AliDarSilenzio/alidu-otamatone/docs/img/tasti.jpg

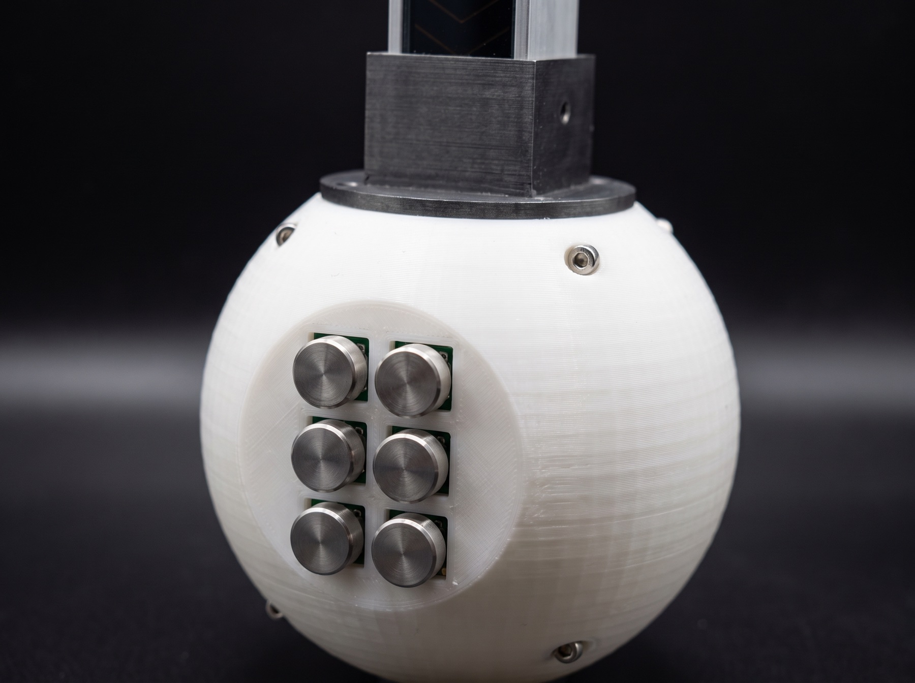
docs/img/tasti.jpg
