AliDarSilenzio/alidu-otamatone/docs/img/nastro.jpg

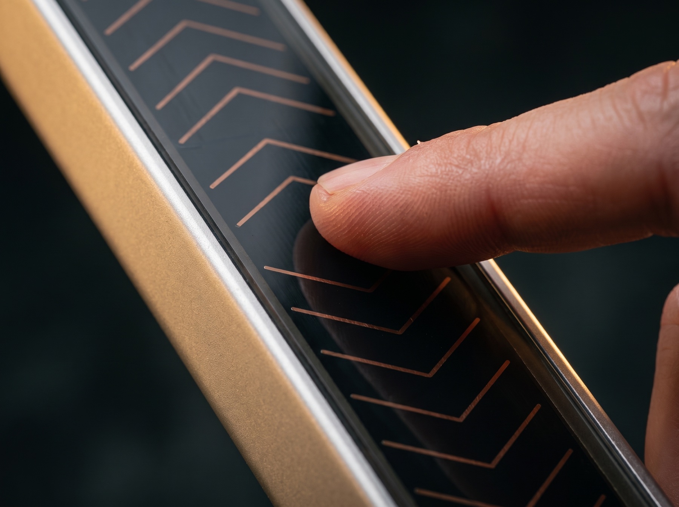
docs/img/nastro.jpg
