AliDarSilenzio/alidu-otamatone/docs/img/connettori.jpg

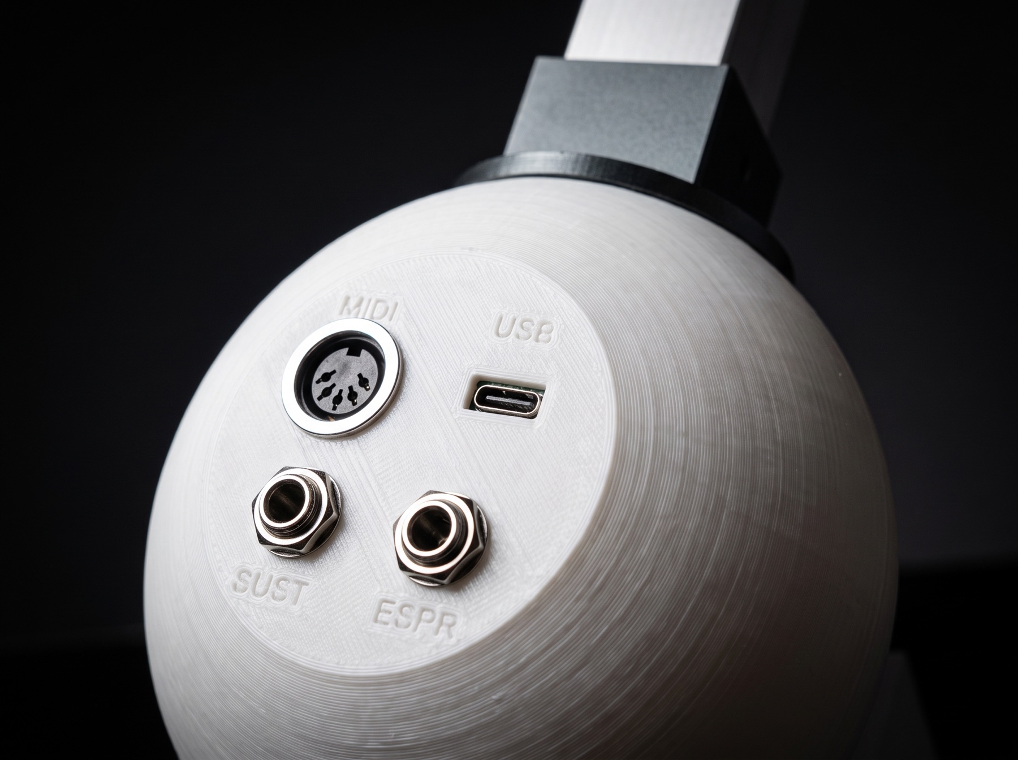
docs/img/connettori.jpg
