AliDarSilenzio/alidu-otamatone/docs/img/esploso.jpg

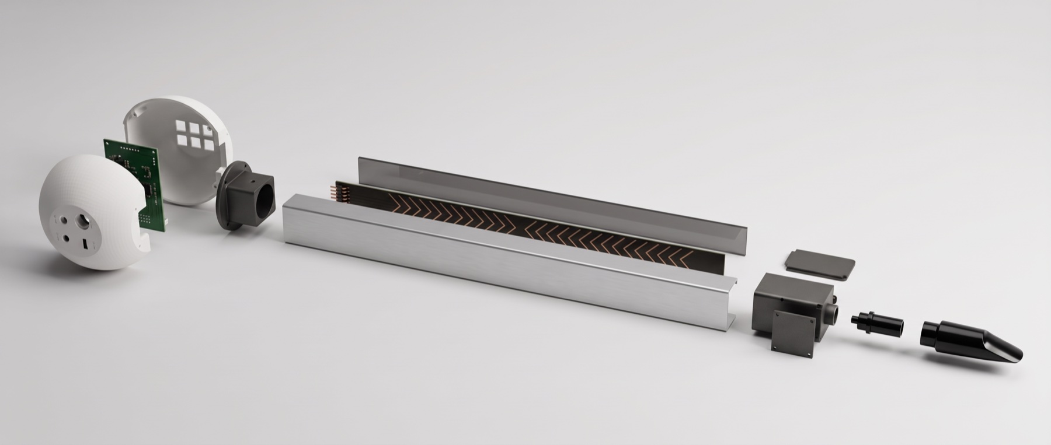
docs/img/esploso.jpg
