AliDarSilenzio/alidu-otamatone/docs/img/mec_assieme.png

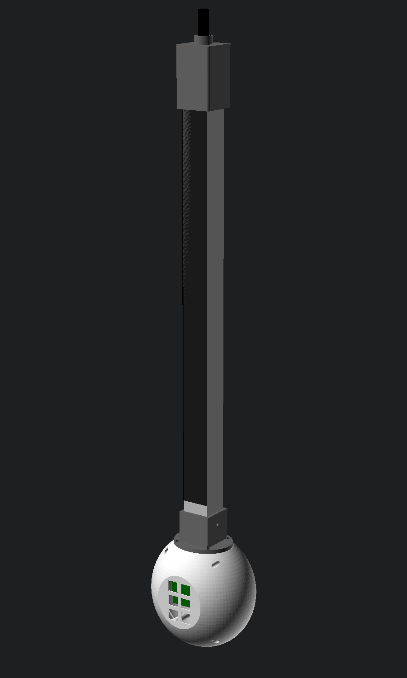
docs/img/mec_assieme.png
