AliDarSilenzio/alidu-otamatone/docs/img/mec_corpo_fronte.png

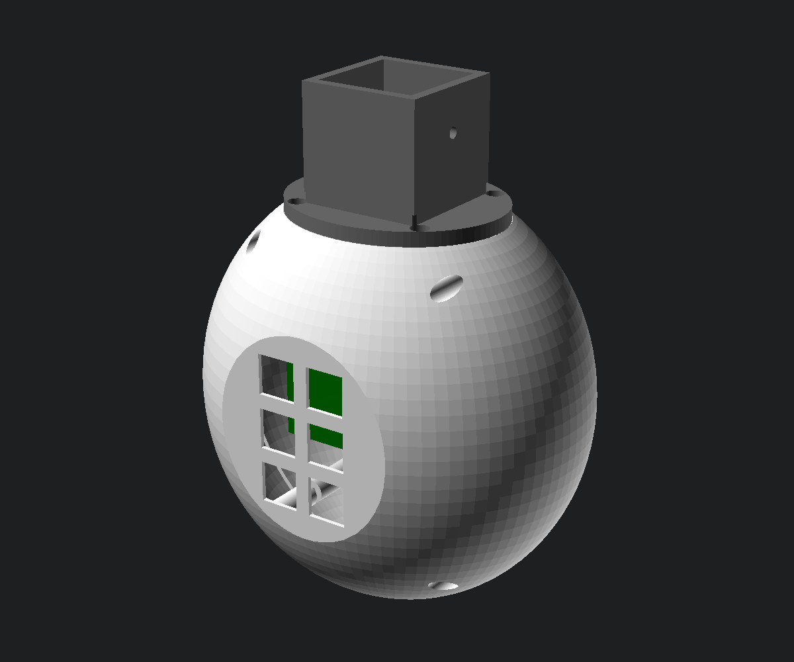
docs/img/mec_corpo_fronte.png
