AliDarSilenzio/alidu-otamatone/docs/img/mec_pezzi.png

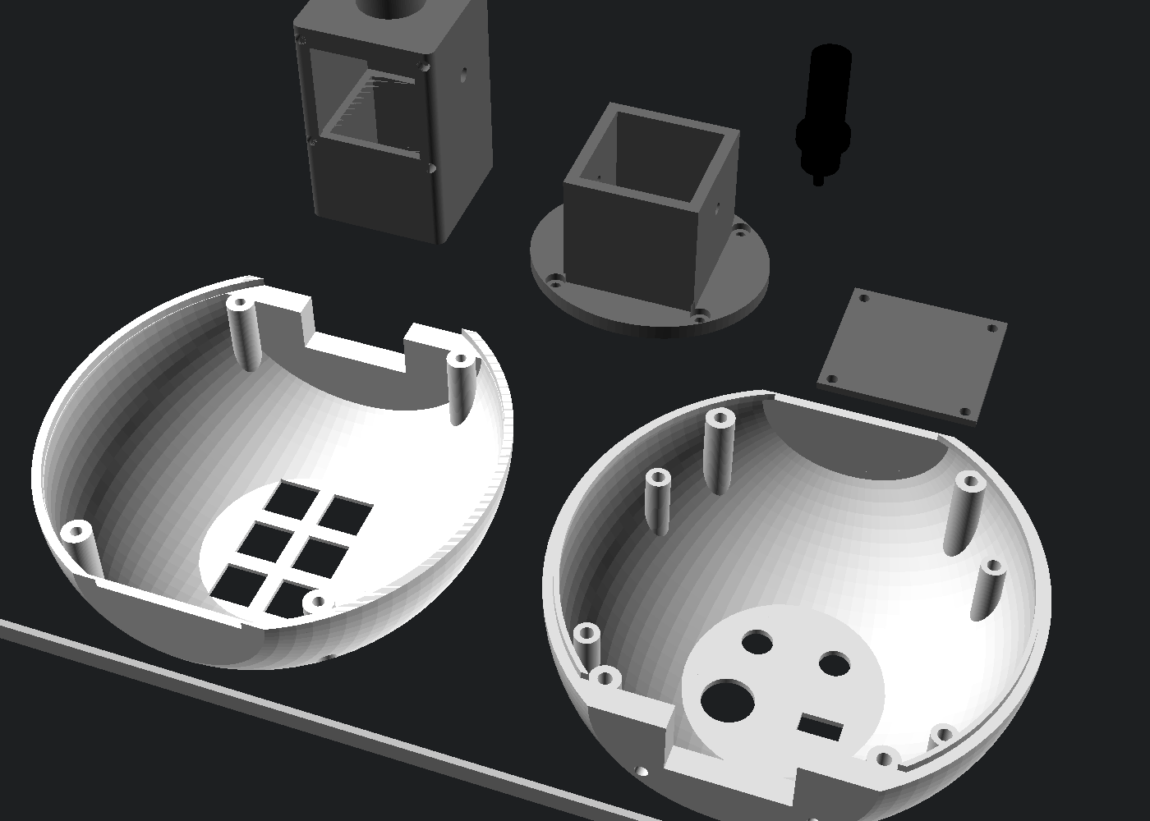
docs/img/mec_pezzi.png
