AliDarSilenzio/alidu-otamatone/docs/img/mec_spaccato.png

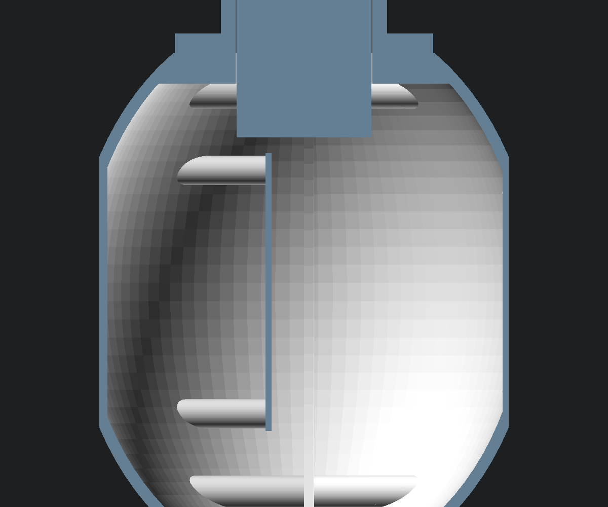
docs/img/mec_spaccato.png
