AliDarSilenzio/alidu-otamatone/docs/img/musicista.jpg

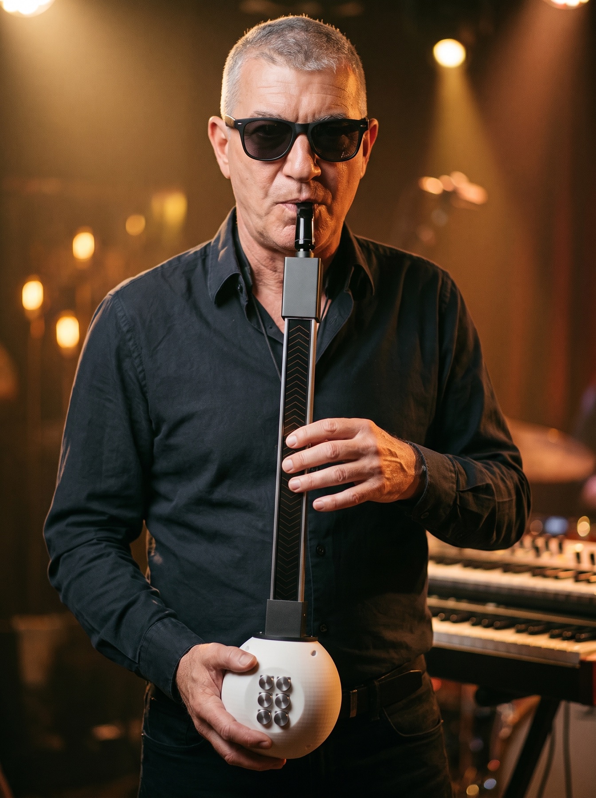
docs/img/musicista.jpg
