AliDarSilenzio/alidu-otamatone/docs/img/pcb_nastro_3d.png

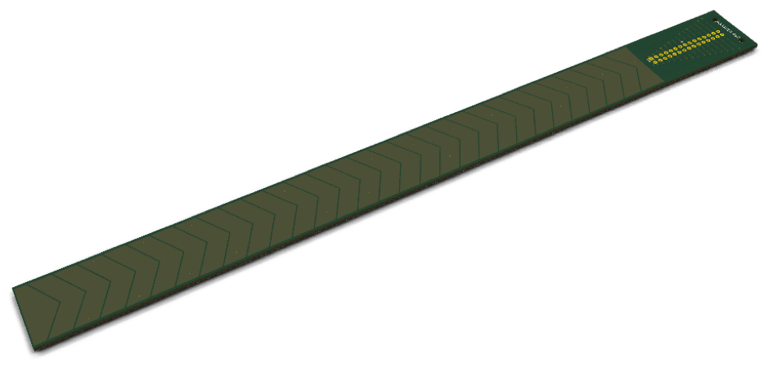
docs/img/pcb_nastro_3d.png
