AliDarSilenzio/alidu-otamatone/docs/img/pcb_nastro_fronte.png

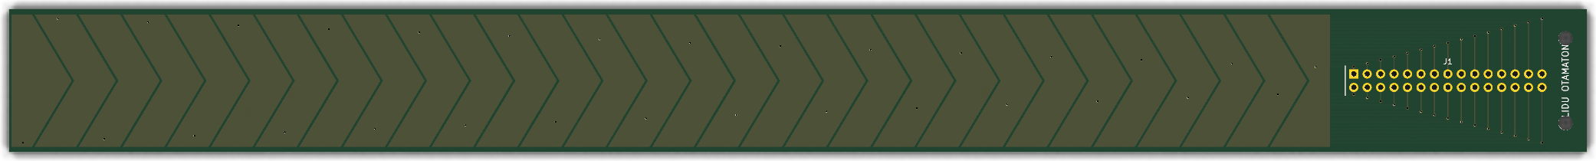
docs/img/pcb_nastro_fronte.png
