AliDarSilenzio/alidu-otamatone/docs/img/pcb_nastro_retro.png

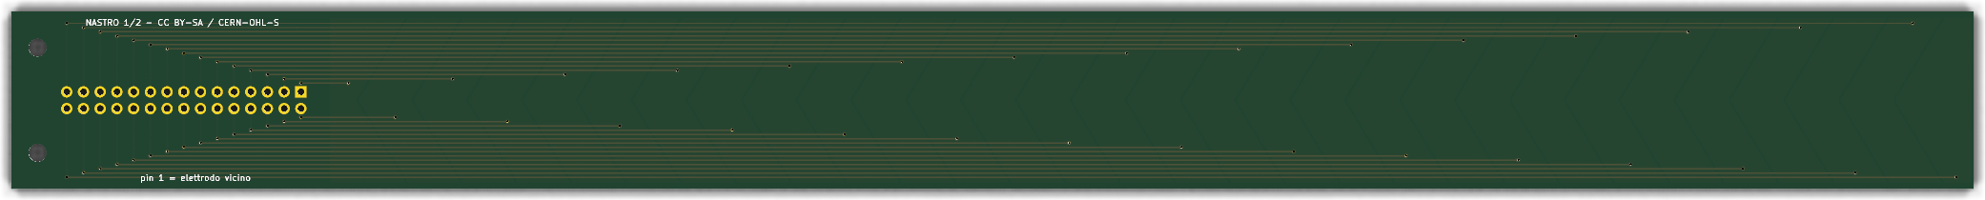
docs/img/pcb_nastro_retro.png
