AliDarSilenzio/alidu-otamatone/docs/img/pcb_scheda_3d.png

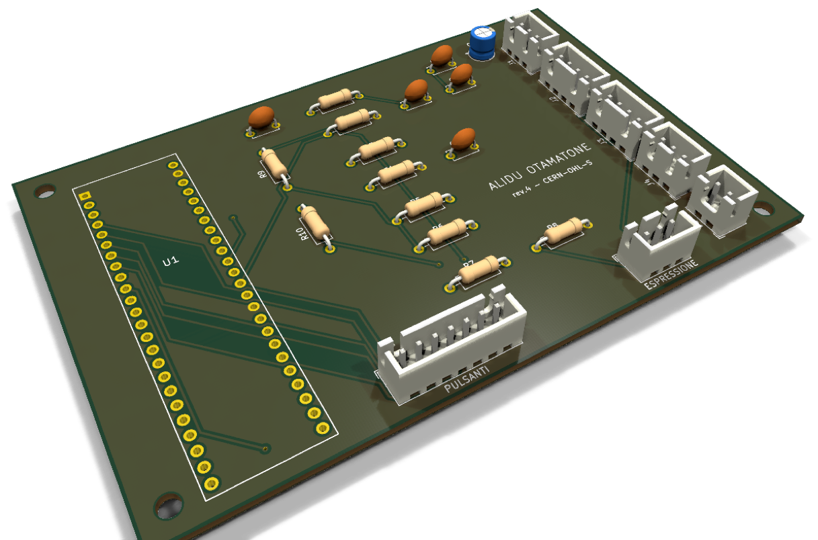
docs/img/pcb_scheda_3d.png
