AliDarSilenzio/alidu-otamatone/docs/img/pcb_scheda_fronte.png

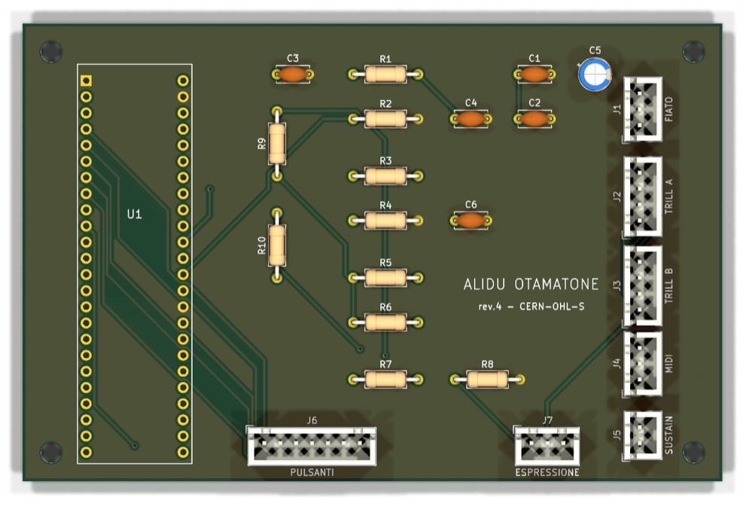
docs/img/pcb_scheda_fronte.png
