AliDarSilenzio/alidu-otamatone/docs/img/pcb_scheda_retro.png

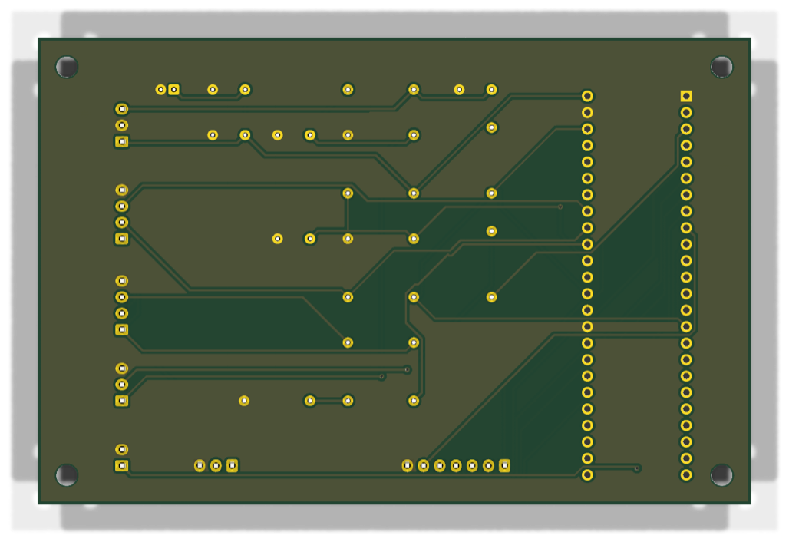
docs/img/pcb_scheda_retro.png
