AliDarSilenzio/alidu-otamatone/docs/img/prodotto.jpg

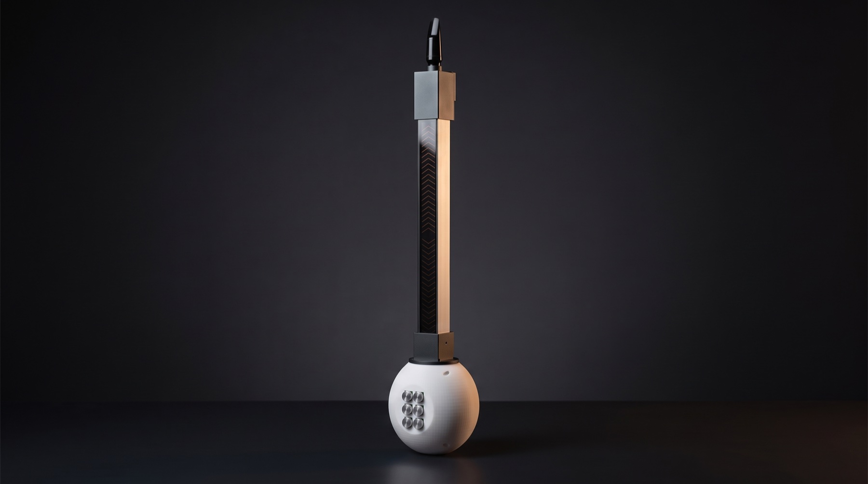
docs/img/prodotto.jpg
