AliDarSilenzio/alidu-otamatone/hardware/nastro/nastro_3d.png

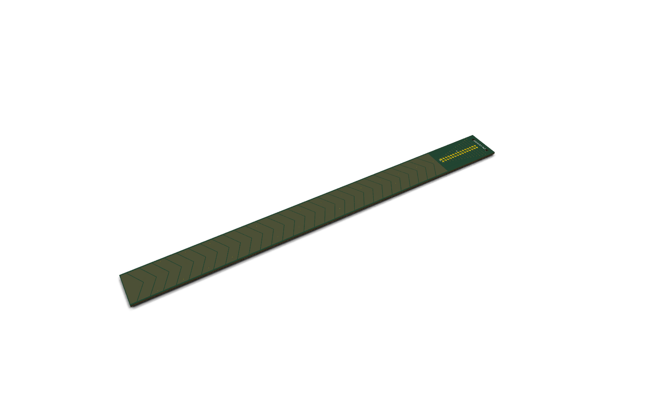
hardware/nastro/nastro_3d.png
