AliDarSilenzio/alidu-otamatone/hardware/nastro/nastro_fronte.png

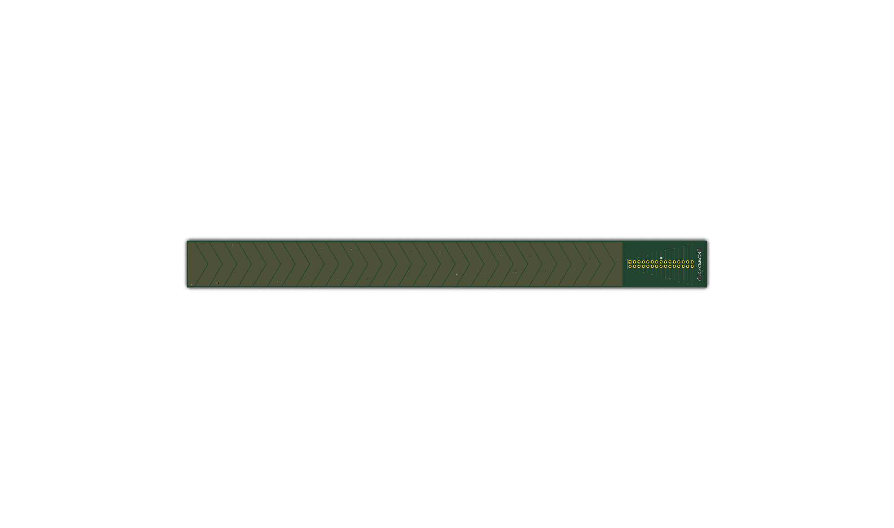
hardware/nastro/nastro_fronte.png
