AliDarSilenzio/alidu-otamatone/hardware/scheda/scheda_3d.png

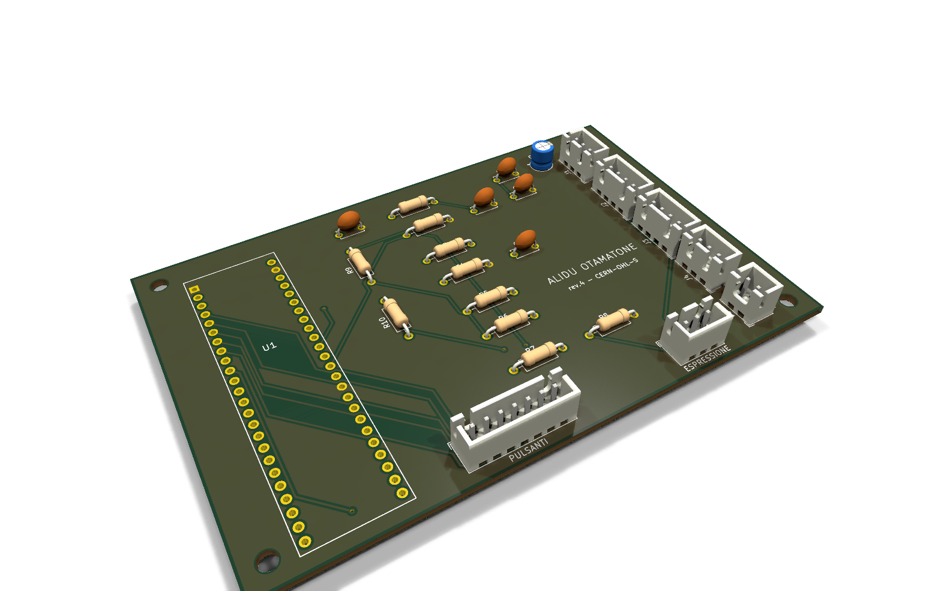
hardware/scheda/scheda_3d.png
