AliDarSilenzio/alidu-otamatone/hardware/scheda/scheda_fronte.png

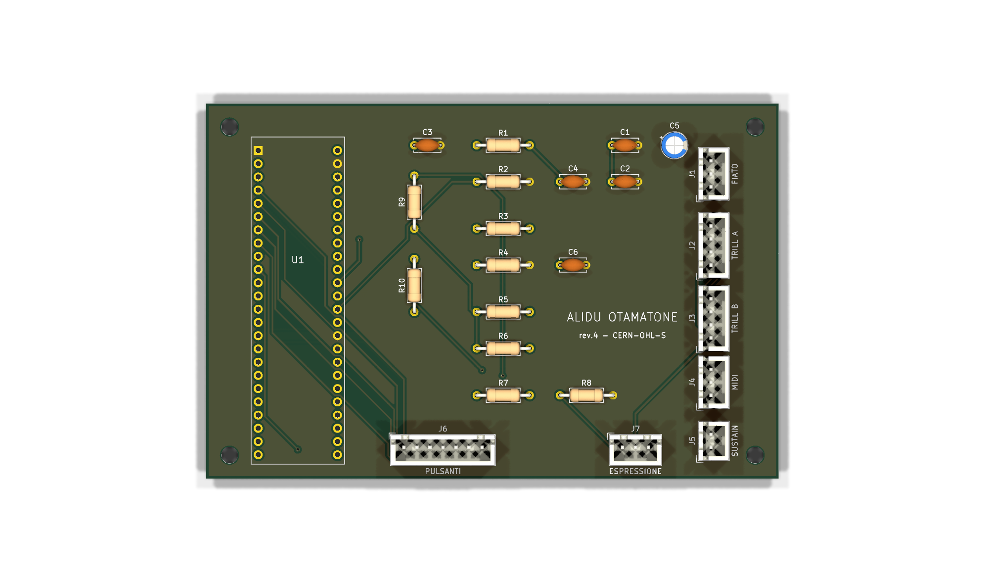
hardware/scheda/scheda_fronte.png
