AliDarSilenzio/alidu-otamatone/hardware/scheda/scheda_retro.png

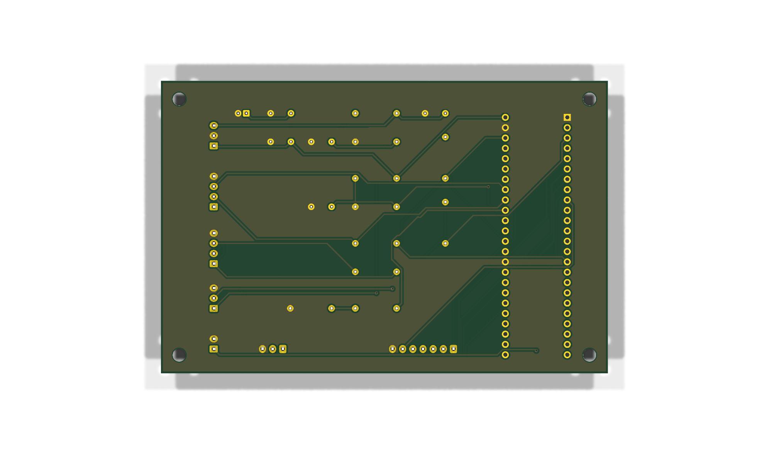
hardware/scheda/scheda_retro.png
