AliDarSilenzio/alidu-otamatone/hardware/meccanica/stl/collare.stl

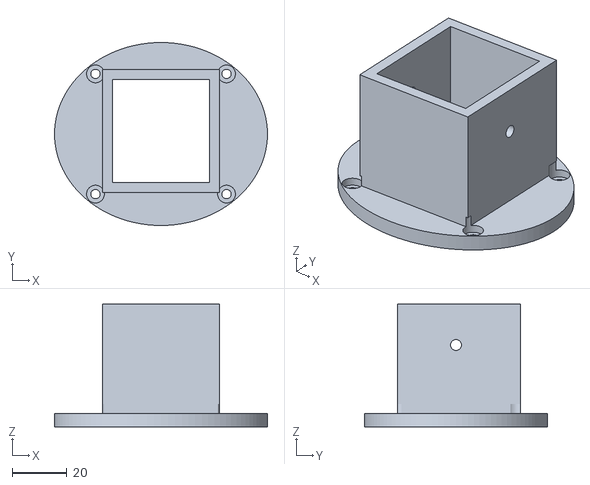
[picture p22: CAD file, 2026-10-10]
hardware/meccanica/stl/collare.stl
78.0 x 67.0 x 45.0
