AliDarSilenzio/alidu-otamatone/hardware/meccanica/stl/testa.stl

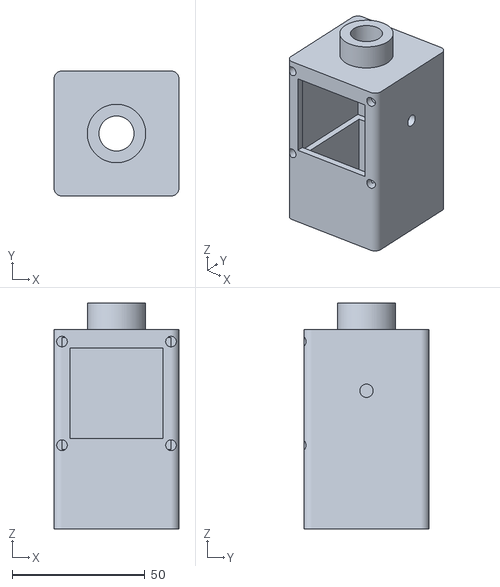
[picture p23: CAD file, 2026-10-10]
hardware/meccanica/stl/testa.stl
47.0 x 47.0 x 85.0
