AliDarSilenzio/alidu-otamatone/hardware/meccanica/stl/corpo_anteriore.stl

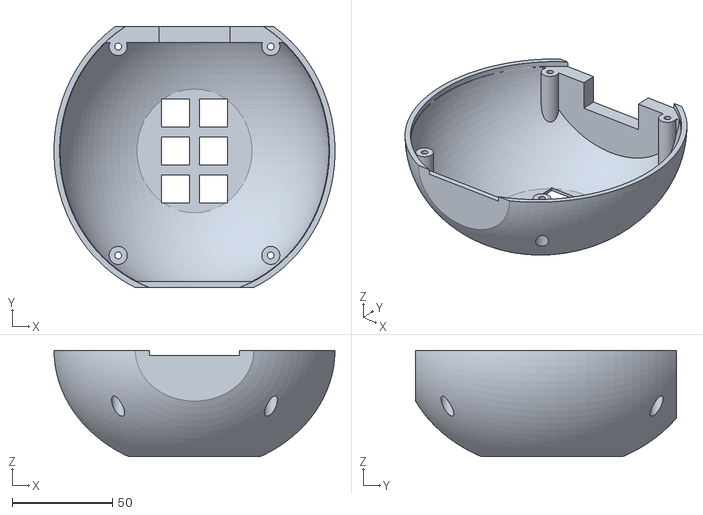
[picture p24: CAD file, 2026-10-10]
hardware/meccanica/stl/corpo_anteriore.stl
139.9 x 130.0 x 53.0
