AliDarSilenzio/alidu-otamatone/hardware/meccanica/stl/guida_nastro.stl

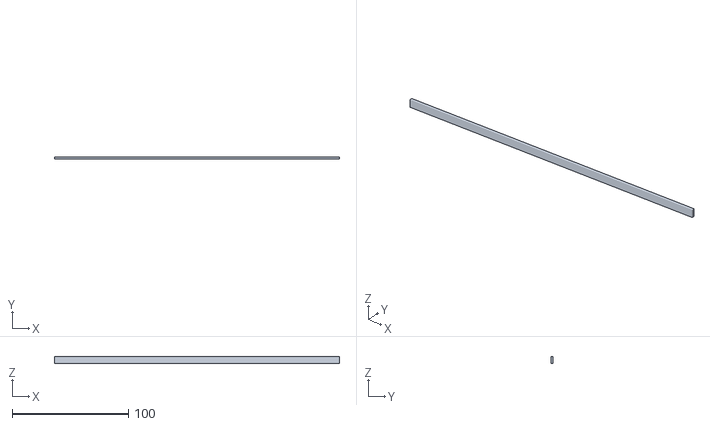
[picture p25: CAD file, 2026-10-10]
hardware/meccanica/stl/guida_nastro.stl
245.0 x 2.00 x 6.00
