AliDarSilenzio/alidu-otamatone/hardware/meccanica/stl/innesto_bocchino.stl

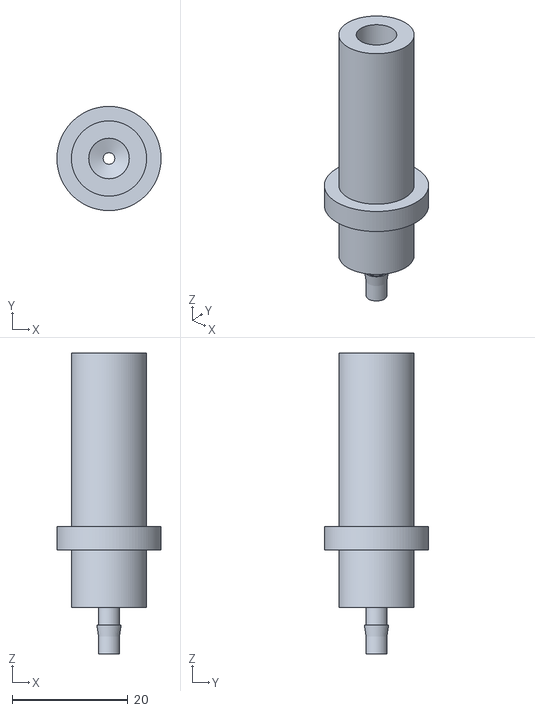
[picture p26: CAD file, 2026-10-10]
hardware/meccanica/stl/innesto_bocchino.stl
18.0 x 18.0 x 52.0
