AliDarSilenzio/alidu-otamatone/hardware/meccanica/stl/testa_coperchio.stl

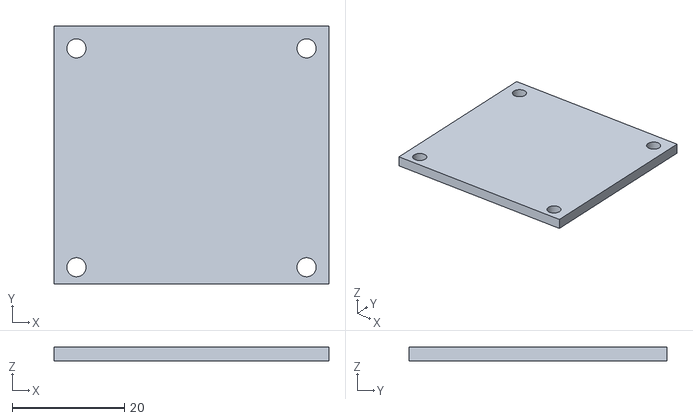
[picture p27: CAD file, 2026-10-10]
hardware/meccanica/stl/testa_coperchio.stl
49.0 x 46.0 x 2.50
