AliDarSilenzio/alidu-otamatone/hardware/meccanica/stl/corpo_posteriore.stl

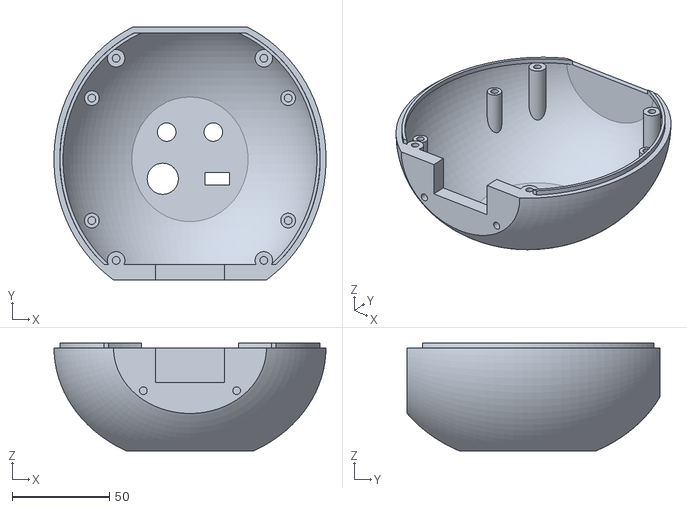
[picture p28: CAD file, 2026-10-10]
hardware/meccanica/stl/corpo_posteriore.stl
139.9 x 130.0 x 55.5
