AliDarSilenzio/alidu-otamatone/docs/img/testa.jpg

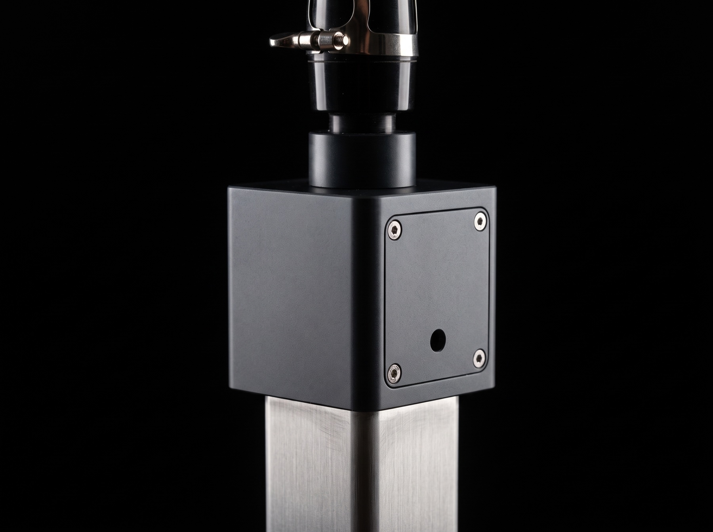
docs/img/testa.jpg
