AliDarSilenzio/alidu-otamatone/AliBreath_schema.pdf

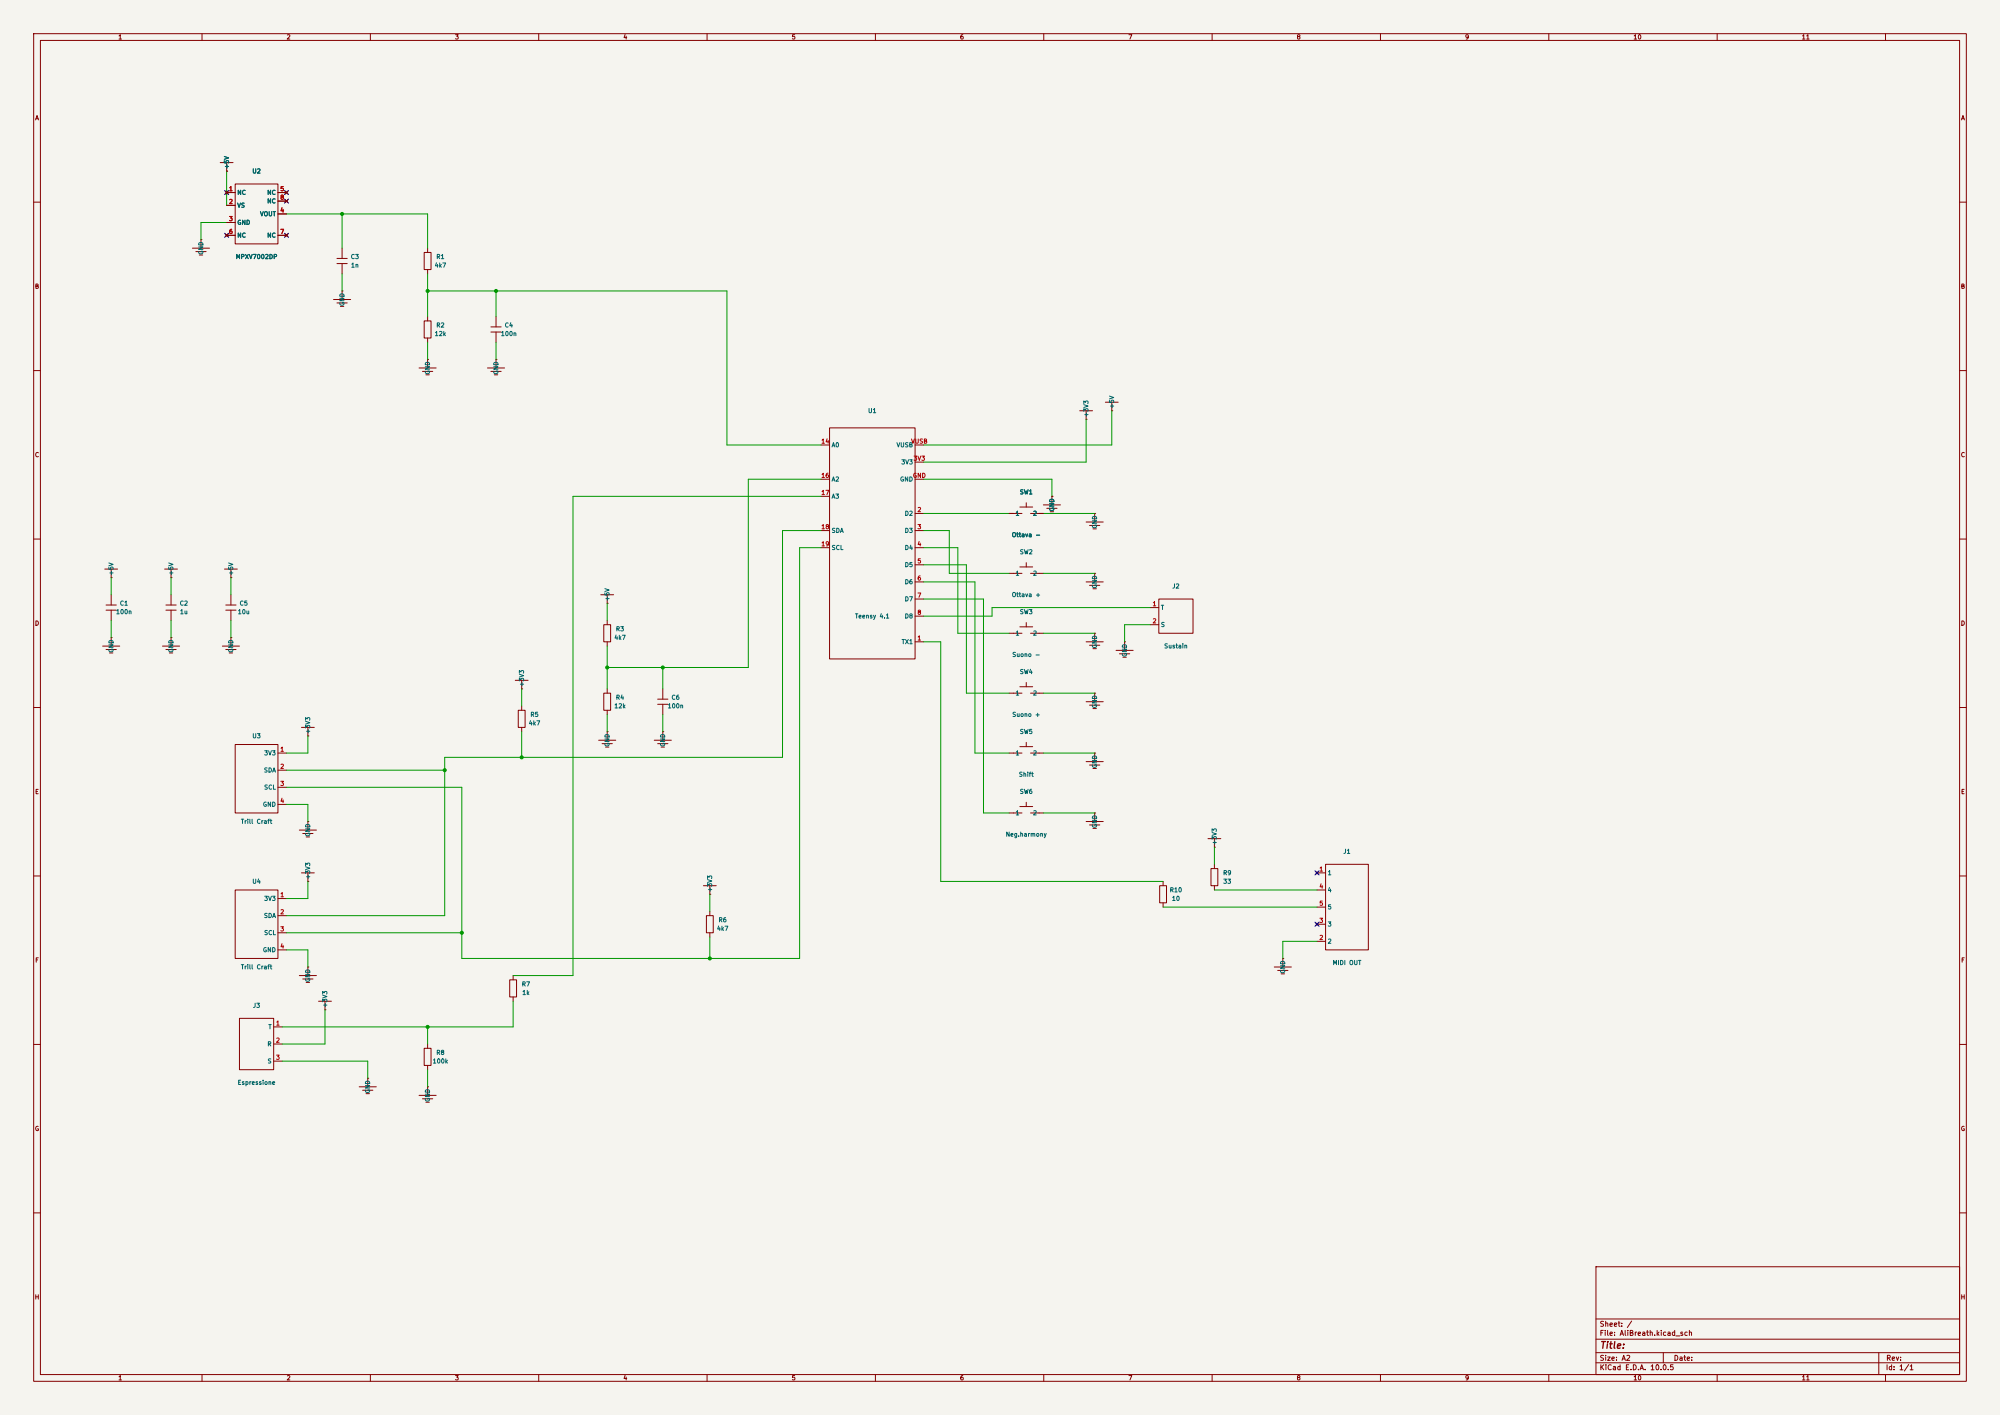
[picture p30: page 1]

Size: A2 | Rev:
KiCad E.D.A. 10.0.5 | Id: 1/1
