AliDarSilenzio/alidu-otamatone/hardware/nastro/nastro.kicad_pcb

## KiCad design hardware/nastro/nastro.kicad_pcb (2026-10-10)

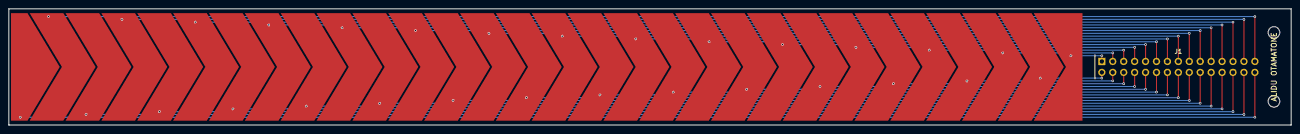
[picture p31: board nastro.kicad_pcb from above]

Board: 2 copper layers, 298.0 x 27.0 mm, 33 parts (0 on the bottom side), 30 nets.

Parts:
E00, E01, E02, E03, E04, E05, E06, E07, E08, E09, E10, E11, E12, E13, E14, E15, E16, E17, E18, E19, E20, E21, E22, E23, E24, E25, E26, E27, E28, E29: Elettrodo
H1, H2: M2.5; Foro_M2.5
J1: 2x15 2,54 mm; Connettore_2x15_P2.54

Connections:
CH00: E00.1, J1.1
CH01: E01.1, J1.2
CH02: E02.1, J1.3
CH03: E03.1, J1.4
CH04: E04.1, J1.5
CH05: E05.1, J1.6
CH06: E06.1, J1.7
CH07: E07.1, J1.8
CH08: E08.1, J1.9
CH09: E09.1, J1.10
CH10: E10.1, J1.11
CH11: E11.1, J1.12
CH12: E12.1, J1.13
CH13: E13.1, J1.14
CH14: E14.1, J1.15
CH15: E15.1, J1.16
CH16: E16.1, J1.17
CH17: E17.1, J1.18
CH18: E18.1, J1.19
CH19: E19.1, J1.20
CH20: E20.1, J1.21
CH21: E21.1, J1.22
CH22: E22.1, J1.23
CH23: E23.1, J1.24
CH24: E24.1, J1.25
CH25: E25.1, J1.26
CH26: E26.1, J1.27
CH27: E27.1, J1.28
CH28: E28.1, J1.29
CH29: E29.1, J1.30
