AliDarSilenzio/alidu-otamatone/hardware/scheda/scheda.kicad_pcb

## KiCad design hardware/scheda/scheda.kicad_pcb (2026-10-10)

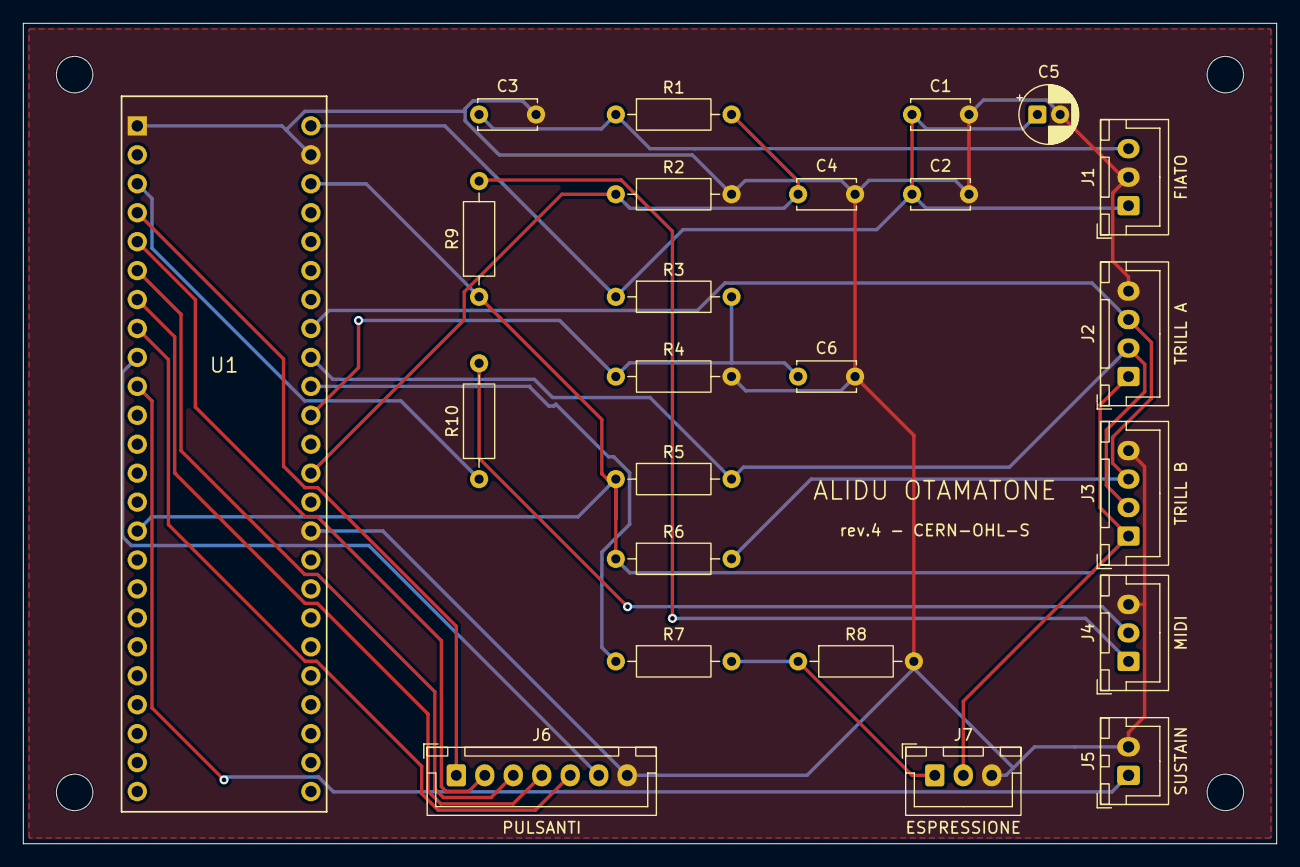
[picture p32: board scheda.kicad_pcb from above]

Board: 2 copper layers, 110.0 x 72.0 mm, 28 parts (0 on the bottom side), 20 nets.

Parts:
C1, C4, C6: 100n; C_Disc_D5.0mm_W2.5mm_P5.00mm
C2: 1u; C_Disc_D5.0mm_W2.5mm_P5.00mm
C3: 1n; C_Disc_D5.0mm_W2.5mm_P5.00mm
C5: 10u; CP_Radial_D5.0mm_P2.00mm
H1, H2, H3, H4: MountingHole_3.2mm_M3
J1: FIATO; JST_XH_B3B-XH-A_1x03_P2.50mm_Vertical
J2: TRILL A; JST_XH_B4B-XH-A_1x04_P2.50mm_Vertical
J3: TRILL B; JST_XH_B4B-XH-A_1x04_P2.50mm_Vertical
J4: MIDI; JST_XH_B3B-XH-A_1x03_P2.50mm_Vertical
J5: SUSTAIN; JST_XH_B2B-XH-A_1x02_P2.50mm_Vertical
J6: PULSANTI; JST_XH_B7B-XH-A_1x07_P2.50mm_Vertical
J7: ESPRESSIONE; JST_XH_B3B-XH-A_1x03_P2.50mm_Vertical
R1, R3, R5, R6: 4k7; R_Axial_DIN0207_L6.3mm_D2.5mm_P10.16mm_Horizontal
R2, R4: 12k; R_Axial_DIN0207_L6.3mm_D2.5mm_P10.16mm_Horizontal
R7: 1k; R_Axial_DIN0207_L6.3mm_D2.5mm_P10.16mm_Horizontal
R8: 100k; R_Axial_DIN0207_L6.3mm_D2.5mm_P10.16mm_Horizontal
R9: 33; R_Axial_DIN0207_L6.3mm_D2.5mm_P10.16mm_Horizontal
R10: 10; R_Axial_DIN0207_L6.3mm_D2.5mm_P10.16mm_Horizontal
U1: Teensy 4.1; Teensy_4.1

Connections:
+3V3: J2.1, J3.1, J7.2, R5.1, R6.1, R9.1, U1.3V3
+5V: C1.1, C2.1, C5.1, J1.1, R3.1, U1.VIN
GND: C1.2, C2.2, C3.2, C4.2, C5.2, C6.2, J1.2, J2.4, J3.4, J4.3, J5.2, J6.7, J7.3, R2.2, R4.2, R8.2, U1.GND
unnamed: J4.1, R9.2
unnamed: J4.2, R10.2
unnamed: J5.1, U1.8
unnamed: J7.1, R7.2, R8.1
unnamed: C4.1, R1.2, R2.1, U1.14
unnamed: C6.1, R3.2, R4.1, U1.16
unnamed: R7.1, U1.17
unnamed: J6.1, U1.2
unnamed: J6.2, U1.3
unnamed: J6.3, U1.4
unnamed: J6.4, U1.5
unnamed: J6.5, U1.6
unnamed: J6.6, U1.7
unnamed: J2.3, J3.3, R6.2, U1.19
unnamed: J2.2, J3.2, R5.2, U1.18
unnamed: R10.1, U1.1
unnamed: C3.1, J1.3, R1.1
