AliDarSilenzio/alidu-otamatone/(commit log)

2026-10-10 Alidu Otamatone: progetto open source completo
    Schema KiCad rev. 4 con nastro capacitivo senza usura, firmware per
    Teensy 4.1 con uscita MIDI USB e DIN, sito del progetto in docs/.
    [AliBreath.kicad_sch]
2026-10-10 Circuiti stampati del nastro e della scheda, guida di costruzione
    - hardware/nastro: circuito del nastro capacitivo, 30 elettrodi a freccia
    su 250 mm; due circuiti uguali, uno ruotato, fanno i 60 elettrodi
    - hardware/scheda: scheda principale con Teensy su zoccolo e connettori
    JST XH, piste tracciate con Freerouting
    - DRC KiCad: 0 errori e 0 collegamenti mancanti su entrambi
    - firmware: ordine dei canali della meta' ruotata, sensibilita'
    impostabile per vetro o acetato
    - sito: pagina costruzione.html, sezione circuiti, nuovi download;
    corretta la descrizione dello sfiato del fiato
    [nastro.kicad_pcb, scheda.kicad_pcb, scheda_posizioni.csv]
2026-10-10 Meccanica stampabile in 3D e aggiornamento del sito
    - hardware/meccanica: sorgente OpenSCAD unico con tutte le misure in
    chiaro; 7 STL (corpo in due gusci, collare, testa e coperchio, innesto
    del bocchino, guida del nastro), tutti solidi validi
    - sito: sezione Stampa 3D, capitolo 9 della guida riscritto con pezzi,
    impostazioni di stampa e montaggio; materiali con inserti e viti
    - download: AliBreath-stampa-3d.zip, pacchetto completo aggiornato
    [alidu_otamatone.scad, collare.stl, corpo_anteriore.stl, corpo_posteriore.stl, guida_nastro.stl, innesto_bocchino.stl, testa.stl, testa_coperchio.stl]
2026-10-10 Foto e video coerenti con il progetto reale
    - tutte le foto rigenerate con Higgsfield a partire dal modello 3D
    vero (OpenSCAD): strumento intero, nastro, tasti, prese, testa e una
    vista esplosa con le parti reali; tolte le immagini concettuali
    - Dario Amabile che suona lo strumento, foto e video
    - video del giro attorno allo strumento rifatto dalla foto nuova
    - collare: sede piu' profonda sul davanti per il vetro da 2 mm
    - modello: viste assieme ed esploso con tasti, prese, frecce del nastro
    e bocchino
    - galleria: le immagini verticali non vengono piu' tagliate
    [alidu_otamatone.scad, collare.stl]
