AliDarSilenzio/alidu-otamatone/(notices)

Notices in the files:
hardware/scheda/scheda.kicad_pcb:
rev.4 - CERN-OHL-S
hardware/nastro/nastro.kicad_pcb:
NASTRO 1/2 - CC BY-SA / CERN-OHL-S
